HyperEngineer/knowles-mic-tester/Daughter-Board/Daughter-Board-BoM.xlsx

Item | Qty | Reference(s) | Value | Category | Description | Digi-Key | Mouser | MPN | Manufacturer | Status
1 | 9 | C101, C102, C103, C104, C105, C106, C107, C108, C109 | 1uF | Capacitor, ceramic | cap cer 1uF 16V X7R 1206 | 478-12854-1-ND |  | 1206YC105KAT2A | Kyocera AVX | Active
2 | 1 | C201 | 100nF | Capacitor ceramic | cap cer 0.1uF 16V X7R 1206 | 476-12852-1-ND |  | 1206YC104KAT2A | Kyocera AVX | Active
3 | 8 | D201 D202 D203 D204 D205 D206 D207 D208 | LED_ALT | LED indicator discrete | LED green clear 25md | 754-1944-1-ND |  | APT3216LZGCK | Kingbright | Active
4 | 1 | J201 | 302-S101 | Connectors Interconnects | CONN HEADER VERT 10POS 2.54MM | ED1543-ND |  | 302-S101 | On Shore Technology Inc. | Active
5 | 4 | J301 J401 J501 J601 | Conn_01x08_0.5mm_Female_Kyocera | Connectors Interconnects | conn fcc bottom 8pos 0.50mm r/a | 478-5454-1-ND |  | 046288008000846+ | Kyocera AVX | Active
6 | 1 | P101 | EdgeConn
7 | 1 | P102 | EdgeConn
8 | 17 | R101 R302 R303 R305 R306 R402 R403 R405 R406 R502 R503 R505 R506 R602 R603 R605 R606 | 100K | chip resistor surface mount | res 100K 1% 1/4W 1206 | 541-4173-1-ND |  | CRCW1206100KFKEAC | Vishay Dale | Active
9 | 8 | R201 R202 R203 R204 R205 R206 R207 R208 | 1.0K | chip resistor surface mount | res 1.0K 1% 1/4W 1206 | 541-CRCW12061K00FKEBCCT-ND |  | CRCW12061K00FKEBC | Vishay Dale | Active
10 | 1 | R209 | 3.9K | chip resistor surface mount | res 3.9K 1% 1/4W 1206 | 541-CRCW12063K90FKEACCT-ND |  | CRCW12063K90FKEAC | Vishay Dale | Active
11 | 8 | R301 R304 R401 R404 R501 R504 R601 R604 | 10K | chip resistor surface mount | res 10K 1% 1/4W 1206 | 541-3983-1-ND |  | CRCW120610K0FKEAC | Vishay Dale | Active
12 | 1 | U101 | LMV934MA | operational amplifiers | op-amp low power 1.8V RRIO quad |  | 926-LMV934MA/NOPB | LMV934MA/NOPB | Texas Instruments | Active
13 | 1 | U102 | LM324A | operational amplifiers | ic opamp 4 circuit 14soic | LM324ADR2GOSCT-ND |  | LM324ADR2G | onsemi | Active
14 | 5 | U103, U104, U105, U108, U109 | 74HC4016 | interface-analog switches | ic switch quad 1x2 14soic | 296-CD74HC4016MTCT-ND |  | CD74HC4016MT | Texas Instruments | Active
15 | 2 | U106, U107 | MC74VHCT126A | buffers line drivers | buffer cmos 4ch non-invert |  | 771-74VHCT126D118 | 74VHCT126D118 | Nexperia | Active
16 | 1 | U201 | 74HC540 | buffers line drivers | ic buffer invert 20soic | 1727-3320-ND |  | 74HC540DB112 | Nexperia | Active
17 | 1 | U202 | PIC32MZ2048EFM064-TQFP | embedded microcontroller | ic mcu 32bit 2mb flash 64tqfp | PIC32MZ2048EFM064-E/PT-ND |  | PIC32MZ2048EFM064-E/PT
