HyperEngineer/knowles-mic-tester/Daughter-Board/Daughter-Board.kicad_pcb

## KiCad design Daughter-Board/Daughter-Board.kicad_pcb (2021-12-28)

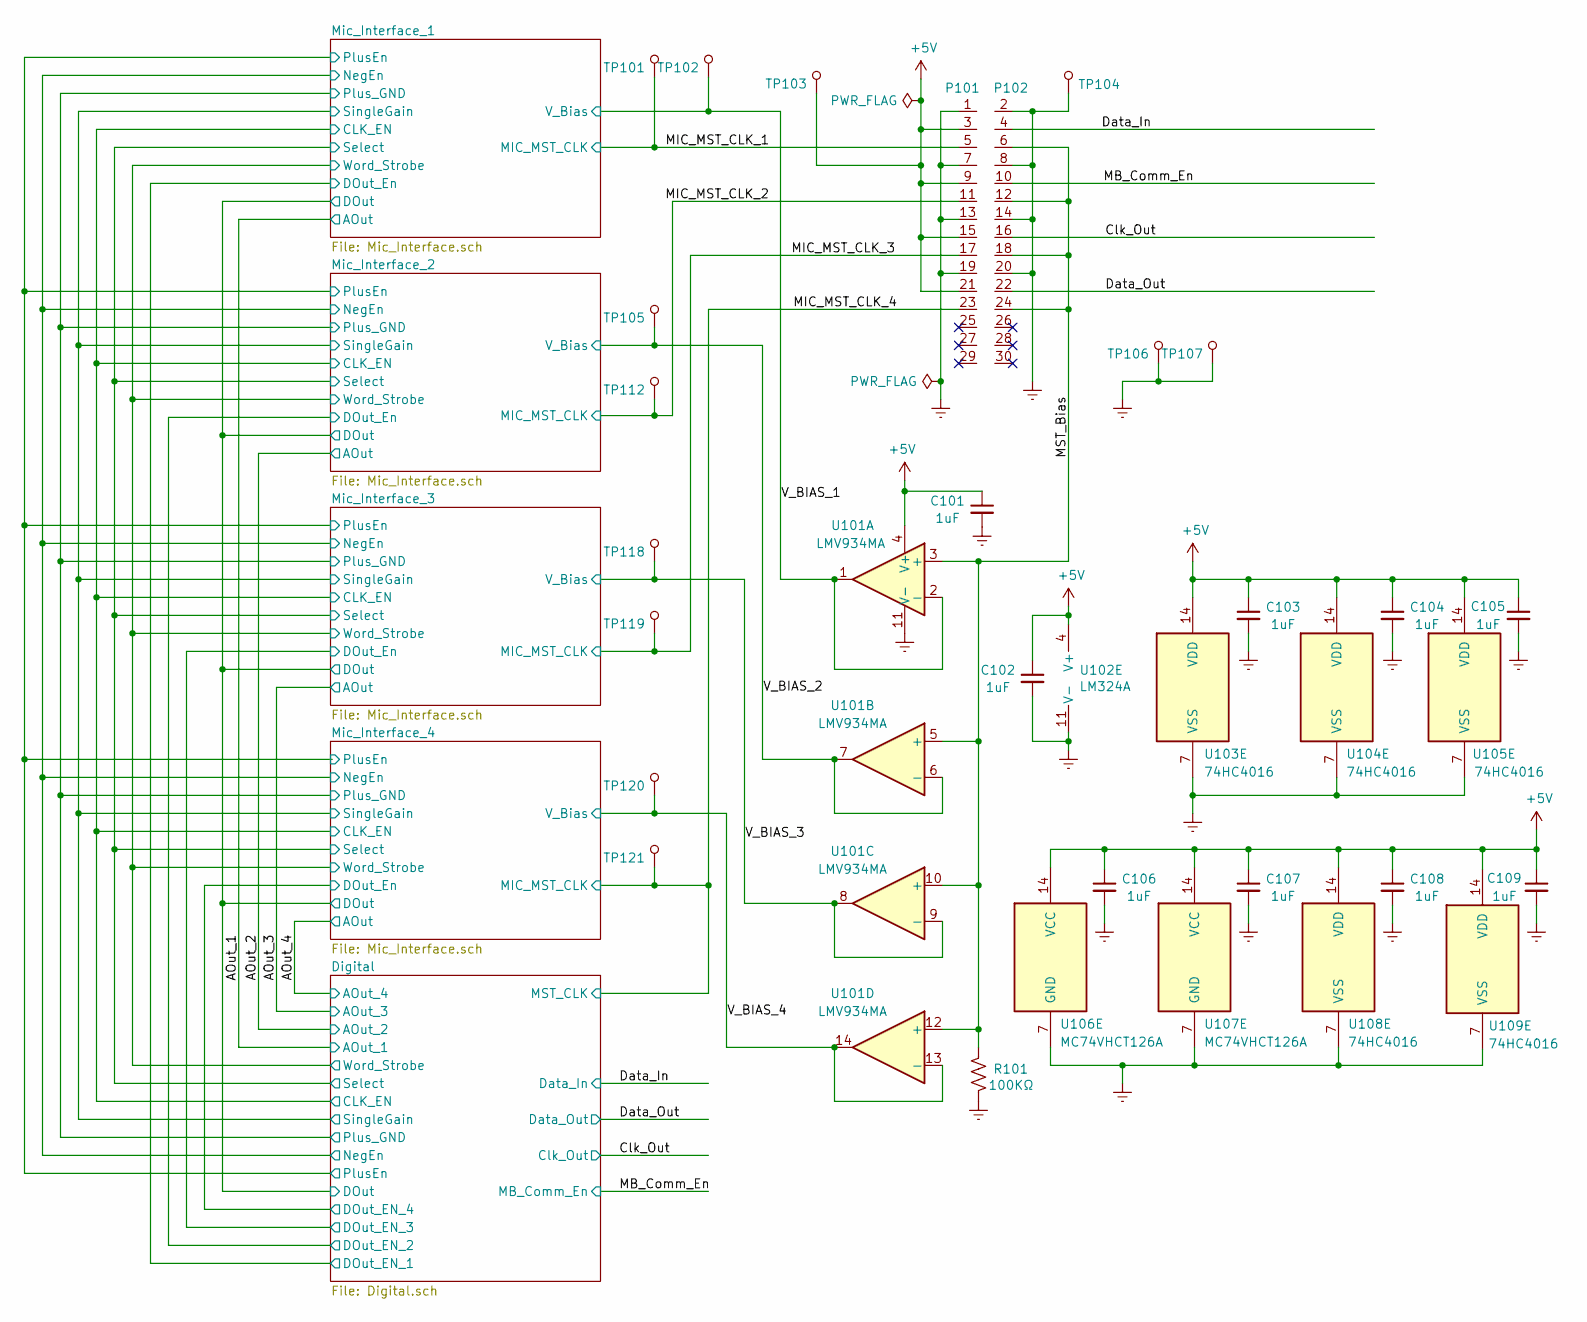
[picture p1: schematic Daughter-Board.sch, Daughter Board]

Parts:
C101, C102, C103, C104, C105, C106, C107, C108, C109: 1uF; C_0805_2012Metric; DigiKey # 478-12854-1-ND
P101: EdgeConn; Component_Side_Edge_Conn_30
P102: EdgeConn; Solder_Side_Edge_Conn_30
R101: 100KΩ; R_0805_2012Metric; DigiKey # 541-4173-1-ND
TP101, TP102, TP103, TP104, TP105, TP106, TP107, TP112, TP118, TP119, TP120, TP121: 5000; TestPoint_Pad_D1.0mm; MPN 5000; Digi-Key_PN 36-5000-ND
U101: LMV934MA; TSSOP-14_4.4x5mm_P0.65mm; Mouser # 926-LMV934MA/NOPB
U102: LM324A; TSSOP-14_4.4x5mm_P0.65mm
U103, U104, U105, U108, U109: 74HC4016; SOIC-14_3.9x8.7mm_P1.27mm; DigiKey # 296-CD74HC4016MTCT-ND
U106: MC74VHCT126A; SOIC-14_3.9x8.7mm_P1.27mm; Mouser # 771-74VHCT126D118
U107: MC74VHCT126A; TSSOP-14_4.4x5mm_P0.65mm; Mouser # 771-74VHCT126D118

Connections:
+5V: C101.1, C102.1, C103.1, C104.1, C105.1, C106.1, C107.1, C108.1, C109.1, P101.3, P101.9, P101.15, P101.21, TP103.1, U101.4 (V+), U102.4 (V+), U103.14 (VDD), U104.14 (VDD), U105.14 (VDD), U106.14 (VCC), U107.14 (VCC), U108.14 (VDD), U109.14 (VDD); also elsewhere on the board
/AOut_2: U102.7; also elsewhere on the board
/AOut_3: U102.14; also elsewhere on the board
/AOut_4: U102.8; also elsewhere on the board
/Clk_Out: P102.16; also elsewhere on the board
/Data_In: P102.4; also elsewhere on the board
/Data_Out: P102.22; also elsewhere on the board
/Digital/CLK_EN: U107.4, U107.10, U107.13; also elsewhere on the board
/Digital/SingleGain: U105.5, U105.6, U105.12; also elsewhere on the board
/MB_Comm_En: P102.10; also elsewhere on the board
/MIC_MST_CLK_1: P101.5, TP101.1; also elsewhere on the board
/MIC_MST_CLK_2: P101.11, TP112.1, U107.5
/MIC_MST_CLK_3: P101.17, TP119.1, U107.9
/MIC_MST_CLK_4: P101.23, TP121.1, U107.12; also elsewhere on the board
/MST_Bias: P102.6, P102.12, P102.18, P102.24, R101.1, U101.3 (+), U101.5 (+), U101.10 (+), U101.12 (+)
/V_BIAS_1: TP102.1, U101.1, U101.2 (-); also elsewhere on the board
/V_BIAS_2: TP105.1, U101.6 (-), U101.7; also elsewhere on the board
/V_BIAS_3: TP118.1, U101.8, U101.9 (-); also elsewhere on the board
/V_BIAS_4: TP120.1, U101.13 (-), U101.14; also elsewhere on the board
GNDREF: C101.2, C102.2, C103.2, C104.2, C105.2, C106.2, C107.2, C108.2, C109.2, P101.1, P101.7, P101.13, P101.19, P102.2, P102.8, P102.14, P102.20, R101.2, TP104.1, TP106.1, TP107.1, U101.11 (V-), U102.11 (V-), U103.7 (VSS), U104.7 (VSS), U105.3, U105.7 (VSS), U105.9, U105.10, U106.7 (GND), U107.7 (GND), U108.7 (VSS), U109.7 (VSS); also elsewhere on the board
unnamed 50: U107.6; also elsewhere on the board
unnamed 54: U107.11; also elsewhere on the board
unnamed 58: U107.8; also elsewhere on the board
unnamed 70: U102.5 (+); also elsewhere on the board
unnamed 72: U105.4; also elsewhere on the board
unnamed 73: U102.6 (-); also elsewhere on the board
unnamed 74: U102.10 (+); also elsewhere on the board
unnamed 76: U105.8; also elsewhere on the board
unnamed 77: U102.9 (-); also elsewhere on the board
unnamed 78: U102.12 (+); also elsewhere on the board
unnamed 80: U105.11; also elsewhere on the board
unnamed 81: U102.13 (-); also elsewhere on the board

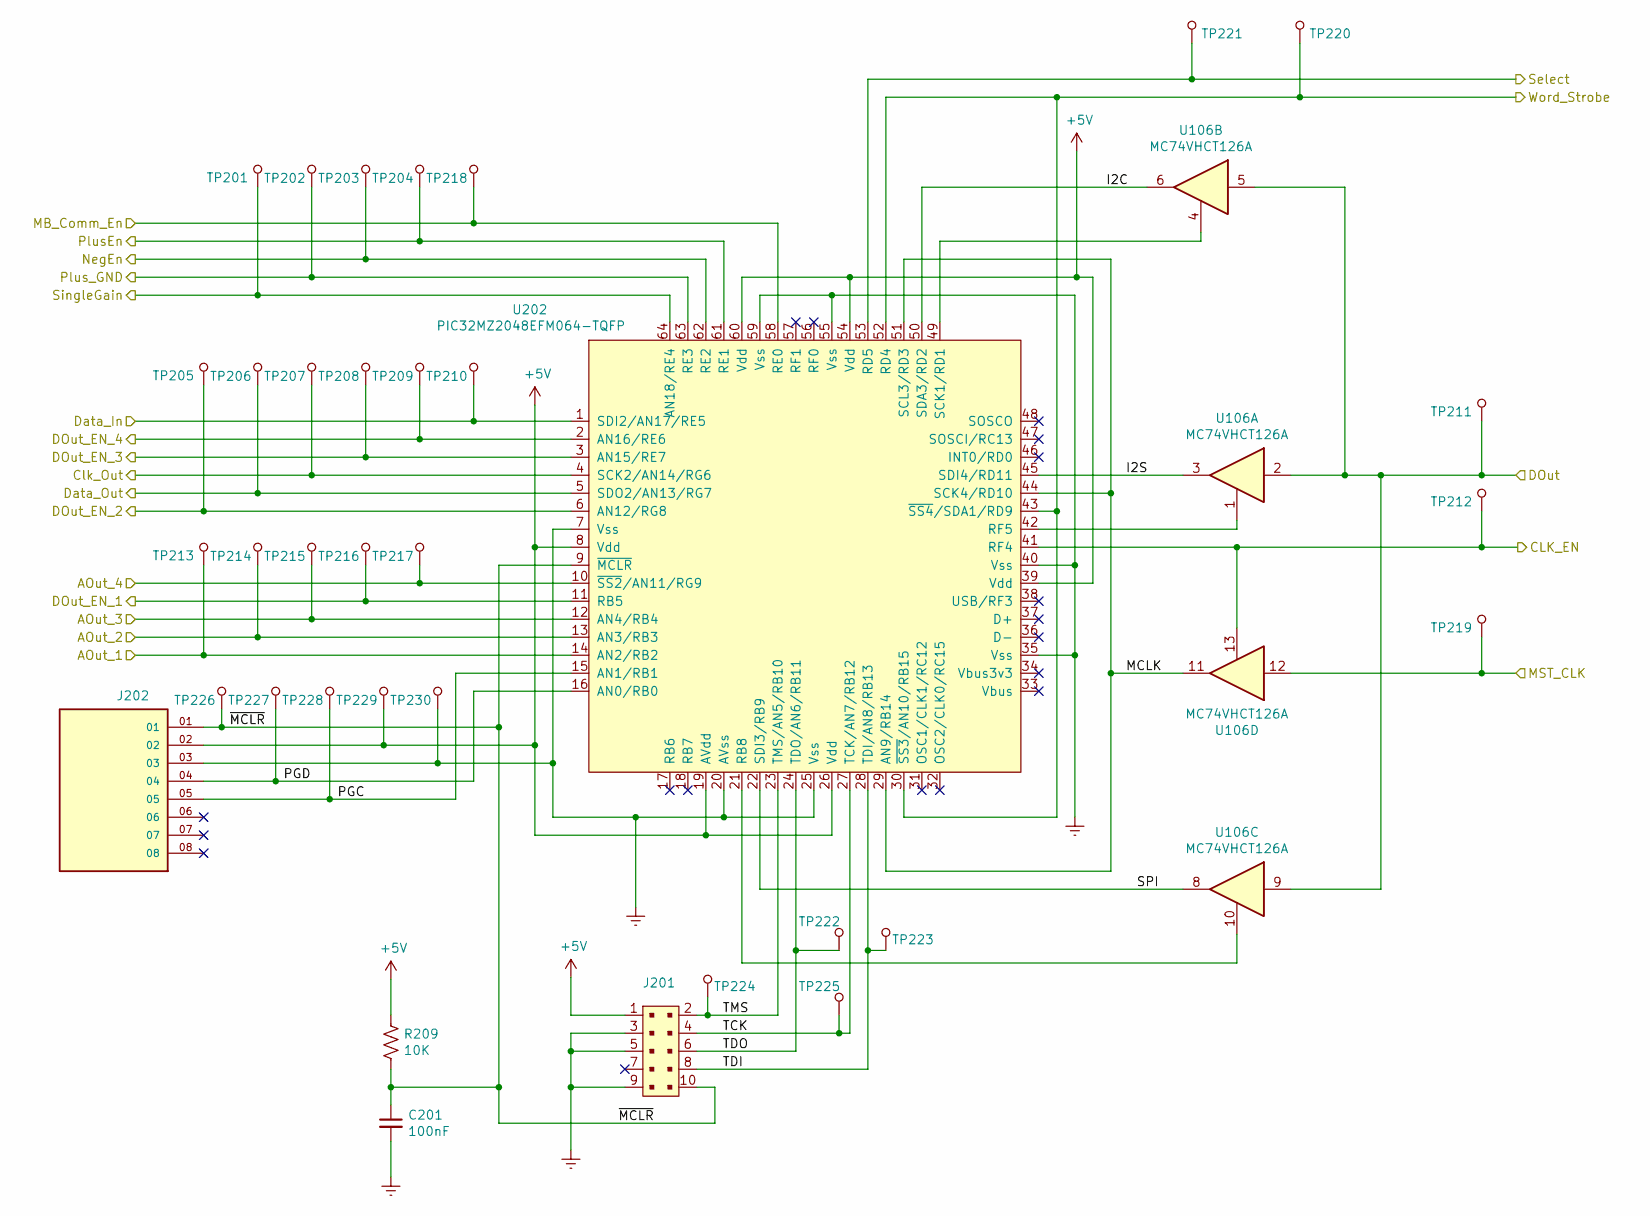
[picture p2: schematic Digital.sch, Daughter Board]

Parts:
C201: 100nF; C_0805_2012Metric; DigiKey # 476-12852-1-ND
J201: 302-S101; PinHeader_2x5_P2.54mm_Drill1.2mm; DigiKey # ED1543-ND
J202: TSW-108-09-G-S-RA; SAMTEC_TSW-108-09-G-S-RA; DigiKey # TSW-108-09-G-S-RA-ND
R209: 10K; R_0805_2012Metric; DigiKey # 541-CRCW12063K90FKEACCT-ND
TP201, TP202, TP203, TP204, TP205, TP206, TP207, TP208, TP209, TP210, TP211, TP212, TP213, TP214, TP215, TP216, TP217, TP218, TP219, TP220, TP221, TP222, TP223, TP224, TP225, TP226, TP227, TP228, TP229, TP230: 5000; TestPoint_Pad_D1.0mm; MPN 5000; Digi-Key_PN 36-5000-ND
U106: MC74VHCT126A; SOIC-14_3.9x8.7mm_P1.27mm
U202: PIC32MZ2048EFM064-TQFP; TQFP-64_10x10mm_P0.5mm; DigiKey # PIC32MZ2048EFM064-E/PT-ND

Connections:
+5V: J201.1, J202.02, R209.1, TP229.1, U202.8 (Vdd), U202.19 (AVdd), U202.26 (Vdd), U202.39 (Vdd), U202.54 (Vdd), U202.60 (Vdd); also elsewhere on the board
/AOut_1: TP213.1, U202.14 (AN2/RB2); also elsewhere on the board
/AOut_2: TP214.1, U202.13 (AN3/RB3); also elsewhere on the board
/AOut_3: TP215.1, U202.12 (AN4/RB4); also elsewhere on the board
/AOut_4: TP217.1, U202.10 (~SS2~/AN11/RG9); also elsewhere on the board
/Clk_Out: TP207.1, U202.4 (SCK2/AN14/RG6); also elsewhere on the board
/Data_In: TP210.1, U202.1 (SDI2/AN17/RE5); also elsewhere on the board
/Data_Out: TP206.1, U202.5 (SDO2/AN13/RG7); also elsewhere on the board
/Digital/CLK_EN: TP212.1, U106.13, U202.41 (RF4); also elsewhere on the board
/Digital/DOut: TP211.1, U106.2, U106.5, U106.9; also elsewhere on the board
/Digital/DOut_EN_1: TP216.1, U202.11 (RB5); also elsewhere on the board
/Digital/DOut_EN_2: TP205.1, U202.6 (AN12/RG8); also elsewhere on the board
/Digital/DOut_EN_3: TP208.1, U202.3 (AN15/RE7); also elsewhere on the board
/Digital/DOut_EN_4: TP209.1, U202.2 (AN16/RE6); also elsewhere on the board
/Digital/I2C: U106.6, U202.50 (SDA3/RD2)
/Digital/I2S: U106.3, U202.45 (SDI4/RD11)
/Digital/MCLK: U106.11, U202.29 (AN9/RB14), U202.44 (SCK4/RD10), U202.51 (SCL3/RD3)
/Digital/NegEn: TP203.1, U202.62 (RE2); also elsewhere on the board
/Digital/PGC: J202.05, TP228.1, U202.15 (AN1/RB1)
/Digital/PGD: J202.04, TP227.1, U202.16 (AN0/RB0)
/Digital/SPI: U106.8, U202.22 (SDI3/RB9)
/Digital/Select: TP221.1, U202.53 (RD5); also elsewhere on the board
/Digital/SingleGain: TP201.1, U202.64 (AN18/RE4); also elsewhere on the board
/Digital/TCK: J201.4, TP225.1, U202.27 (TCK/AN7/RB12)
/Digital/TDI: J201.8, TP223.1, U202.28 (TDI/AN8/RB13)
/Digital/TDO: J201.6, TP222.1, U202.24 (TDO/AN6/RB11)
/Digital/TMS: J201.2, TP224.1, U202.23 (TMS/AN5/RB10)
/Digital/Word_Strobe: TP220.1, U202.30 (~SS3~/AN10/RB15), U202.43 (~SS4~/SDA1/RD9), U202.52 (RD4); also elsewhere on the board
/Digital/~MCLR: C201.1, J201.10, J202.01, R209.2, TP226.1, U202.9 (~MCLR)
/MB_Comm_En: TP218.1, U202.58 (RE0); also elsewhere on the board
/MIC_MST_CLK_4: TP219.1, U106.12; also elsewhere on the board
GNDREF: C201.2, J201.3, J201.5, J201.9, J202.03, TP230.1, U202.7 (Vss), U202.20 (AVss), U202.25 (Vss), U202.35 (Vss), U202.40 (Vss), U202.55 (Vss), U202.59 (Vss); also elsewhere on the board
unnamed: U106.1, U202.42 (RF5)
unnamed: U106.4, U202.49 (SCK1/RD1)
unnamed: U106.10, U202.21 (RB8)
PlusEn: TP204.1, U202.61 (RE1); also elsewhere on the board
Plus_GND: TP202.1, U202.63 (RE3); also elsewhere on the board

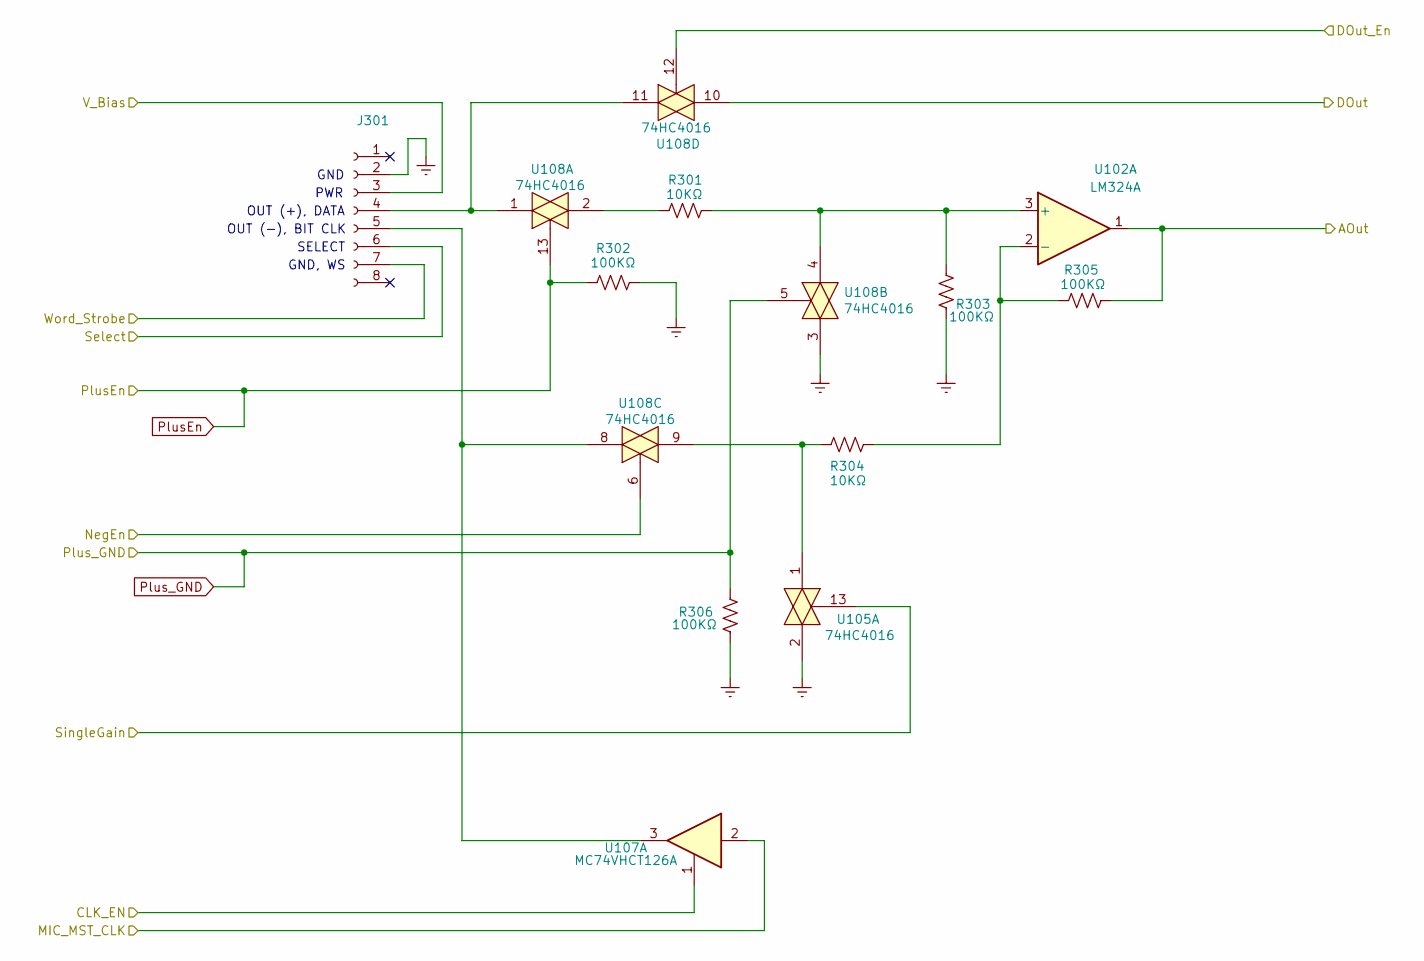
[picture p3: schematic Mic_Interface.sch, Daughter Board]

Parts:
J301: Conn_01x08_0.5mm_Female_Kyocera; Kyocera_6288; Digi-Key 478-5454-1-ND
R301, R304: 10KΩ; R_0805_2012Metric; DigiKey # 541-3983-1-ND
R302: 100KΩ; R_0805_2012Metric; DigiKey # 5414173-1-ND
R303, R305: 100KΩ; R_0805_2012Metric; DigiKey # 541-4173-1-ND
R306: 100KΩ; R_0805_2012Metric
U102: LM324A; TSSOP-14_4.4x5mm_P0.65mm
U105, U108: 74HC4016; SOIC-14_3.9x8.7mm_P1.27mm
U107: MC74VHCT126A; SOIC-14_3.9x8.7mm_P1.27mm; Mouser # 771-74VHCT126D118

Connections:
/AOut_1: R305.1, U102.1; also elsewhere on the board
/AOut_2: U102.7; also elsewhere on the board
/AOut_3: U102.14; also elsewhere on the board
/AOut_4: U102.8; also elsewhere on the board
/Digital/CLK_EN: U107.1, U107.4, U107.10, U107.13; also elsewhere on the board
/Digital/DOut: U108.10; also elsewhere on the board
/Digital/DOut_EN_1: U108.12; also elsewhere on the board
/Digital/NegEn: U108.6; also elsewhere on the board
/Digital/Select: J301.6; also elsewhere on the board
/Digital/SingleGain: U105.5, U105.6, U105.12, U105.13; also elsewhere on the board
/Digital/Word_Strobe: J301.7; also elsewhere on the board
/MIC_MST_CLK_1: U107.2; also elsewhere on the board
/MIC_MST_CLK_2: U107.5; also elsewhere on the board
/MIC_MST_CLK_3: U107.9; also elsewhere on the board
/MIC_MST_CLK_4: U107.12; also elsewhere on the board
/V_BIAS_1: J301.3; also elsewhere on the board
GNDREF: J301.2, R302.1, R303.1, R306.1, U105.2, U105.3, U105.9, U105.10, U108.3; also elsewhere on the board
unnamed: J301.4, U108.1, U108.11
unnamed: J301.5, U107.3, U108.8
unnamed 50: U107.6; also elsewhere on the board
unnamed 54: U107.11; also elsewhere on the board
unnamed 58: U107.8; also elsewhere on the board
unnamed: R301.1, R303.2, U102.3 (+), U108.4
unnamed: R301.2, U108.2
unnamed: R304.1, U105.1, U108.9
unnamed: R304.2, R305.2, U102.2 (-)
unnamed 70: U102.5 (+); also elsewhere on the board
unnamed 72: U105.4; also elsewhere on the board
unnamed 73: U102.6 (-); also elsewhere on the board
unnamed 74: U102.10 (+); also elsewhere on the board
unnamed 76: U105.8; also elsewhere on the board
unnamed 77: U102.9 (-); also elsewhere on the board
unnamed 78: U102.12 (+); also elsewhere on the board
unnamed 80: U105.11; also elsewhere on the board
unnamed 81: U102.13 (-); also elsewhere on the board
PlusEn: R302.2, U108.13; also elsewhere on the board
Plus_GND: R306.2, U108.5; also elsewhere on the board

Parts of its further copies:
J401, J501, J601: Conn_01x08_0.5mm_Female_Kyocera; Kyocera_6288; Digi-Key 478-5454-1-ND
R401, R404, R501, R504, R601, R604: 10KΩ; R_0805_2012Metric; DigiKey # 541-3983-1-ND
R402, R502, R602: 100KΩ; R_0805_2012Metric; DigiKey # 5414173-1-ND
R403, R405, R503, R505, R603, R605: 100KΩ; R_0805_2012Metric; DigiKey # 541-4173-1-ND
R406, R506, R606: 100KΩ; R_0805_2012Metric

Connections of its further copies:
/AOut_2: R405.1; also elsewhere on the board
/AOut_3: R605.1; also elsewhere on the board
/AOut_4: R505.1; also elsewhere on the board
/Digital/Select: J401.6, J501.6, J601.6; also elsewhere on the board
/Digital/Word_Strobe: J401.7, J501.7, J601.7; also elsewhere on the board
/V_BIAS_2: J401.3; also elsewhere on the board
/V_BIAS_3: J601.3; also elsewhere on the board
/V_BIAS_4: J501.3; also elsewhere on the board
GNDREF: J401.2, J501.2, J601.2, R402.1, R403.1, R406.1, R502.1, R503.1, R506.1, R602.1, R603.1, R606.1; also elsewhere on the board
unnamed 49: J401.4; also elsewhere on the board
unnamed 50: J401.5; also elsewhere on the board
unnamed 53: J501.4; also elsewhere on the board
unnamed 54: J501.5; also elsewhere on the board
unnamed 57: J601.4; also elsewhere on the board
unnamed 58: J601.5; also elsewhere on the board
unnamed 70: R401.1, R403.2; also elsewhere on the board
unnamed 71: R401.2; also elsewhere on the board
unnamed 72: R404.1; also elsewhere on the board
unnamed 73: R404.2, R405.2; also elsewhere on the board
unnamed 74: R501.1, R503.2; also elsewhere on the board
unnamed 75: R501.2; also elsewhere on the board
unnamed 76: R504.1; also elsewhere on the board
unnamed 77: R504.2, R505.2; also elsewhere on the board
unnamed 78: R601.1, R603.2; also elsewhere on the board
unnamed 79: R601.2; also elsewhere on the board
unnamed 80: R604.1; also elsewhere on the board
unnamed 81: R604.2, R605.2; also elsewhere on the board
PlusEn: R402.2, R502.2, R602.2; also elsewhere on the board
Plus_GND: R406.2, R506.2, R606.2; also elsewhere on the board

Notes on the sheet:
PWR
GND
OUT (+), DATA
OUT (-), BIT CLK
SELECT
GND, WS

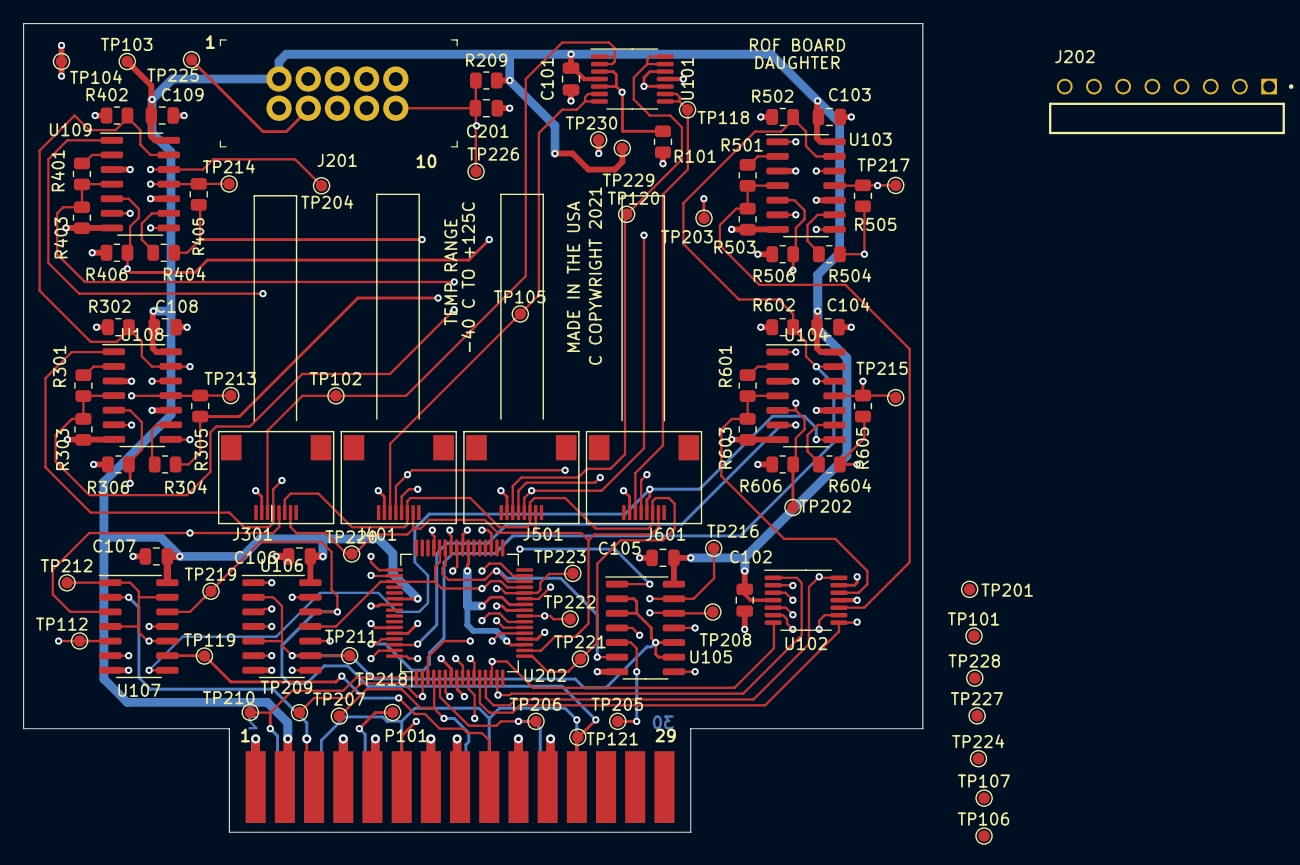
[picture p4: board Daughter-Board.kicad_pcb from above]

Board: 4 copper layers, 78.2 x 70.4 mm, 96 parts (1 on the bottom side), 69 nets.
