HyperEngineer/knowles-mic-tester/(commit log)

2021-10-13 changed n-type MOSFETs to cd4016 plus minor changes
    [Daughter-Board.kicad_pcb, Daughter-Board.sch, Digital.sch, Mic_Interface.sch, Mother-Board.kicad_pcb, Mother-Board.sch]
2021-12-02 Add test points to Digital and Daughter-Board schematics
    [Daughter-Board.kicad_pcb, Daughter-Board.sch, Digital.sch, Mic_Interface.sch]
2021-12-02 Really add Excel BoM file.
    [Daughter-Board-BoM.xlsx]
2021-12-02 Update component footprint for U102E.
    [Daughter-Board.kicad_pcb]
2021-12-02 Add DigiKey # or Mouser # to component info, update footprintinfo for 14 and 20 pin devices.
    [Daughter-Board.sch, Digital.sch, Mic_Interface.sch]
2021-12-13 Corrected analog gain switch position.
    Analog gain switch was across the feedback resistor. It is changed to grounding of the - input resistor to the op amp.
    [Daughter-Board.kicad_pcb, Daughter-Board.sch, Digital.sch, Mic_Interface.sch]
2021-12-18 Remove LEDs and circuitry, update J201 footprint to have a square pad on pin 1.]
    [Daughter-Board.kicad_pcb, Digital.sch, Mic_Interface.sch]
2021-12-20 Add connector for PICkit to MCU interface.
    In the process of adding the PICkit connector some control lines had to be moved.
    [Daughter-Board.kicad_pcb, Daughter-Board.sch, Digital.sch, Mic_Interface.sch]
2021-12-28 Modify schematic to recover PCB layout.
    [Daughter-Board.kicad_pcb, Daughter-Board.sch, Digital.sch, Mic_Interface.sch]
